Akinava/pip-boy/doc/img/console_1_front.jpg

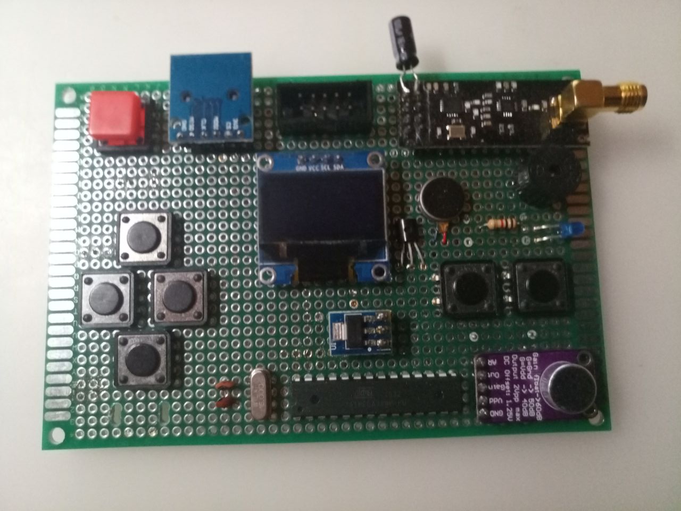
doc/img/console_1_front.jpg
