Akinava/pip-boy/doc/img/console_1_back.jpg

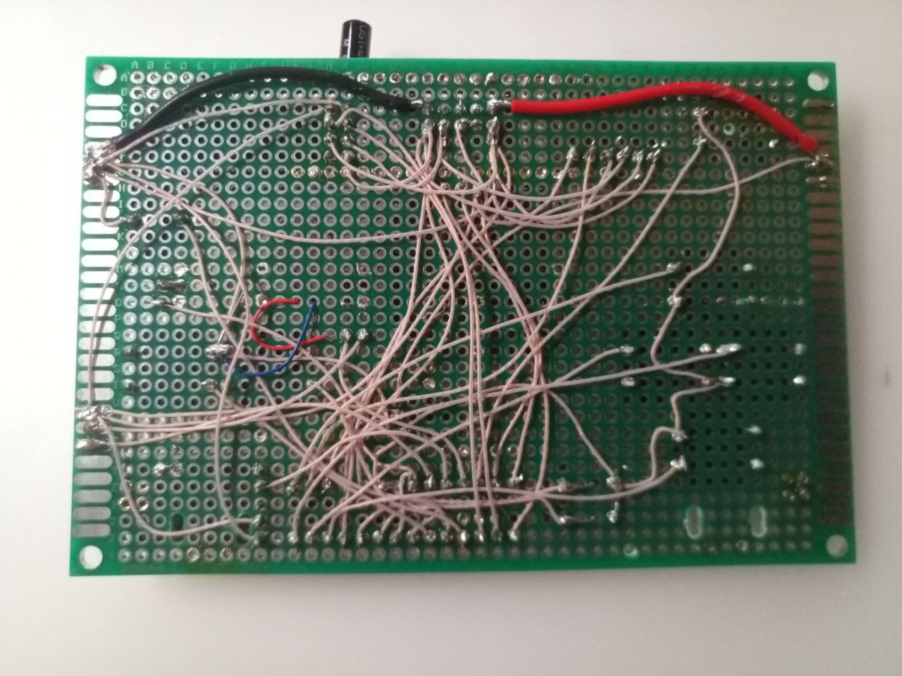
doc/img/console_1_back.jpg
