Akinava/pip-boy/doc/img/console_0_back.jpg

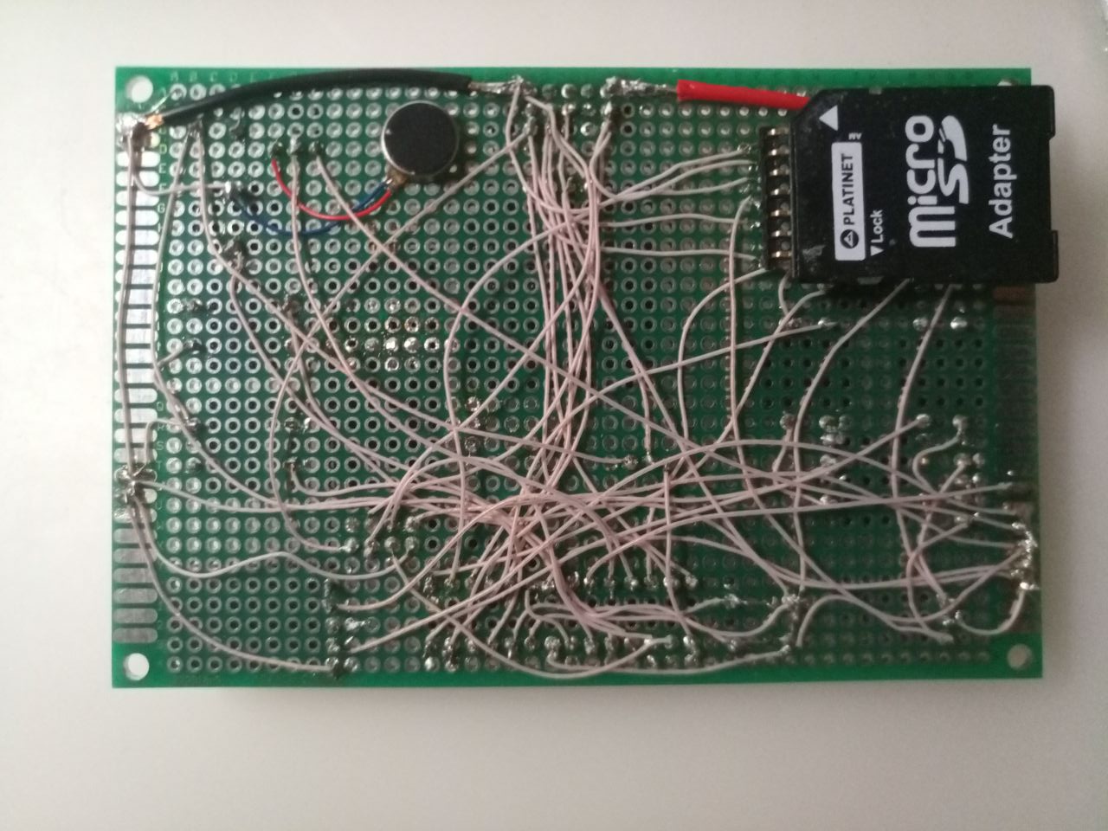
doc/img/console_0_back.jpg
