Akinava/pip-boy/doc/img/console_0_front.jpg

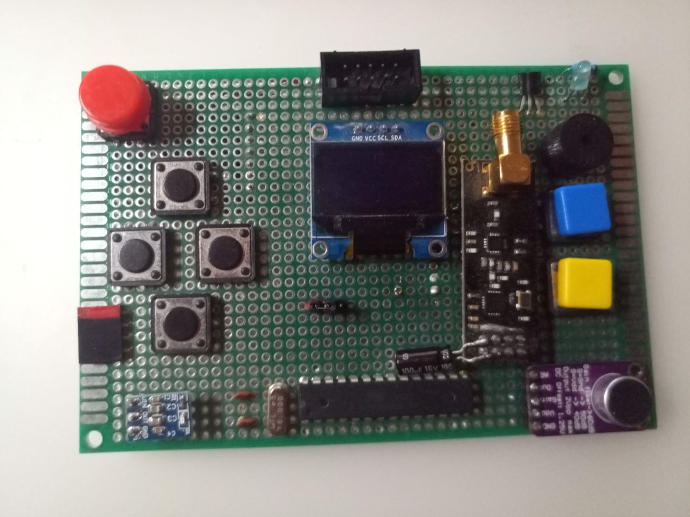
doc/img/console_0_front.jpg
