Akinava/pip-boy/doc/TODO.txt

# soft
file manager / copy, move, delite a file | create, copy, move a directory | send file via radio link
text editor / hex, ascii, utf
grafic editor https://en.wikipedia.org/wiki/Netpbm
chat
walkie-talkie
port games from arduboy
port games from gamebuino
mp3 player https://www.mikrocontroller.net/topic/391086 https://embdev.net/topic/370373

# hard
change edge connector on PCB
create box model for 3d printer
