Akinava/pip-boy/(list of files, drawings)

Other design files:
doc/display/VirtOs_1.02/æσÑ¼á 1.02.spl7
doc/schima.fzz
