Akinava/pip-boy/src/spi_writer/display.h

#include <avr/pgmspace.h>
#include <string.h>
#include "macro.h"
#include "pins.h"

#ifndef DISPLAY_H
#define DISPLAY_H

// FIXME
void clean_buf(void);
void print4(uint8_t n, uint8_t x, uint8_t y);
void print8(uint8_t n, uint8_t x, uint8_t y);
void print16(uint16_t n, uint8_t x, uint8_t y);
void print32(uint32_t n, uint8_t x, uint8_t y);
void print4inv(uint8_t n, uint8_t x, uint8_t y);
void print8inv(uint8_t n, uint8_t x, uint8_t y);
void print16inv(uint16_t n, uint8_t x, uint8_t y);
void print32inv(uint32_t n, uint8_t x, uint8_t y);


void display_begin(void);
void display_clean(void);
void print(char* str, uint8_t x, uint8_t y);
void print_invert(char* str, uint8_t x, uint8_t y);

#define SSD1306_ADDR                              0x3C
#define SSD1306_SET_START_LINE                    0x40
#define SSD1306_SET_SEGMENT_REMAP                 0xA0
#define SSD1306_COMMAND                           0x00
#define SSD1306_SET_COLUMN_ADDR                   0x21
#define SSD1306_SET_PAGE_ADDR                     0x22
#define SSD1306_DATA                              0x40
#define TWI_FREQ 400000L
#define __cbi2(sfr, bit) (_SFR_BYTE(sfr) &= ~_BV(bit))

#define FONT_OFFSET 32
#define FONT_WIDTH 5
#define FONT_HEIGHT 8

void i2c_init_(void);
void i2c_start_();
void i2c_stop_();
void i2c_command_(uint8_t command);
void print_string_(char* str, uint8_t x, uint8_t y);
void print_char_(uint8_t c, uint8_t buff_offset);
void display_update_(uint8_t y);

uint8_t display_buff_[128];
uint8_t invert_text_;
#endif
