Akinava/pip-boy/(commit log)

2019-11-26 Added ADC pins / added NRF24L01
2019-12-22 mapping pins to arduino
2019-12-30 fix I2C pin name
2020-01-07 bootloader stage 3
2020-02-03 print vol address
2020-02-06 fixed boot file name
    [boot.h]
2020-02-20 it works but doesn't start
    [boot.c, boot.h]
2020-02-20 reset issue / size 2740b
    [sd.c]
2020-03-01 boot loader works / reset problem
    [boot.c, boot.h, sd.c, sd.h]
2020-03-03 wdt still has an issue
    [boot.c]
2020-03-04 fix led
2020-03-05 sbs fuses
2020-03-07 example print char
2020-03-07 print string
2020-03-07 print invert done
2020-03-08 rm meddle lines print
2020-03-15 work but fail with read dir
    [file_manager.c, sd.c, sd.h]
2020-03-18 set direction/fix out border
    [file_manager.c, file_manager.h, sd.c, sd.h]
2020-05-07 fix find prev cluster
    [file_manager.c, file_manager.h, sd.c, sd.h]
2020-05-16 fix error "page above"
    [file_manager.c, file_manager.h, sd.c, sd.h]
2020-05-20 cluster and sector issue is found / the code need to be cleaned
    [boot.c, boot.h]
2020-06-02 test battery lvl done
2020-06-11 boot load status led added
2020-06-12 add SPI doc
2020-06-12 SPI writer init
2020-06-18 fuses are written
2020-06-19 spi switch issue
2020-06-19 sd|master/spi conflict
2020-06-22 reorganize doc dir
    [schima.fzz, æσÑ¼á 1.02.spl7]
2020-07-27 spi init
2020-07-28 add configure spi speed
